MatthewCalligaro/E155Final/Reference/FPGAPinAssignments.JPG

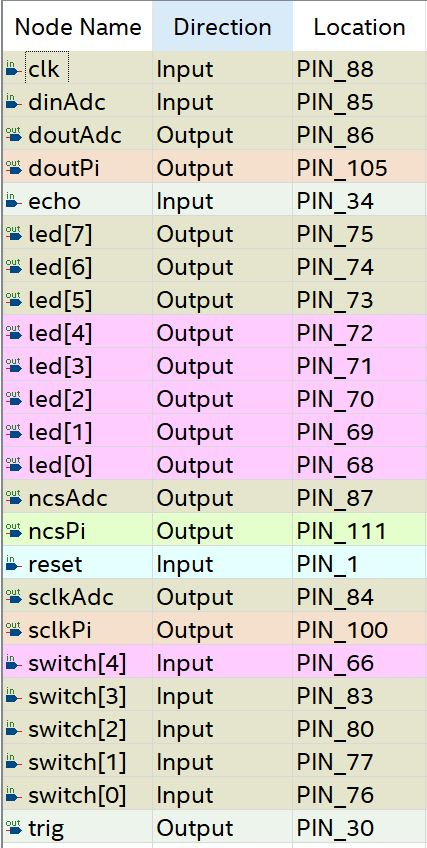
Reference/FPGAPinAssignments.JPG
