MatthewCalligaro/E155Final/(commit log)

2018-11-25 Create Quartus project for distance sensor
    Copied from my lab 1; compiles without errors, no testing has been done
2018-11-25 Convince distance sensor to spit something back
    I don't know why this works but it uh approximately does
2018-11-25 fixed chorus, added gate to reduce noise
    [FPGA.sv, testbench.sv]
2018-11-26 Pretty up distance sensor code
2018-11-26 Enhance prettiness of distance sensor code
2018-11-28 Bump mem to 15
    And yet, I think we'll need to do an average filter.
2018-12-08 Recover distance sensor code
    What even happened, man?
2018-12-08 Restore functionality pre-reset
    Yeah, this is a struggle.
    [distance.sv]
2018-12-08 Fix warnings from last commit, also catch slight pastebug
    [distance.sv]
2018-12-08 Reorganized FPGA logic into modules, more work for removing noise
    [FPGA.sv, calibrate.sv, effects.sv, testbench.sv]
2018-12-09 Fix size of save
    [distance.sv]
2018-12-09 Fix avg warning regarding truncate
    [distance.sv]
2018-12-09 removed noise from stored value
    [FPGA.sv, effects.sv, testbench.sv]
2018-12-09 Revert "Reformat distsensor"
    This reverts commit 729337b3dfb1a8a87661030494c7c00d02ab0195.
    [distance.sv]
2018-12-09 major refactoring of distance sensor code, integrating distance with effects
2018-12-10 Modify run pseudotarget for thread priority
2018-12-10 added configurable second offset for reducing noise
    [FPGA.sv, calibrate.sv, distance.sv, effects.sv]
2018-12-10 Print ip in getIPaddress()
2018-12-10 Error-check to remove localhost ip
    [receiver.c]
2018-12-10 Error out with localhost
    [receiver.c]
2018-12-10 Fix unrelated typo; respace
    [receiver.c]
2018-12-10 Handle errors by admitting you don't know things
    [receiver.c]
2019-01-12 Added reference materials
